jonthomasson/sx1238-500mw-rf-transceiver/rev1.a/img/3d-front.png

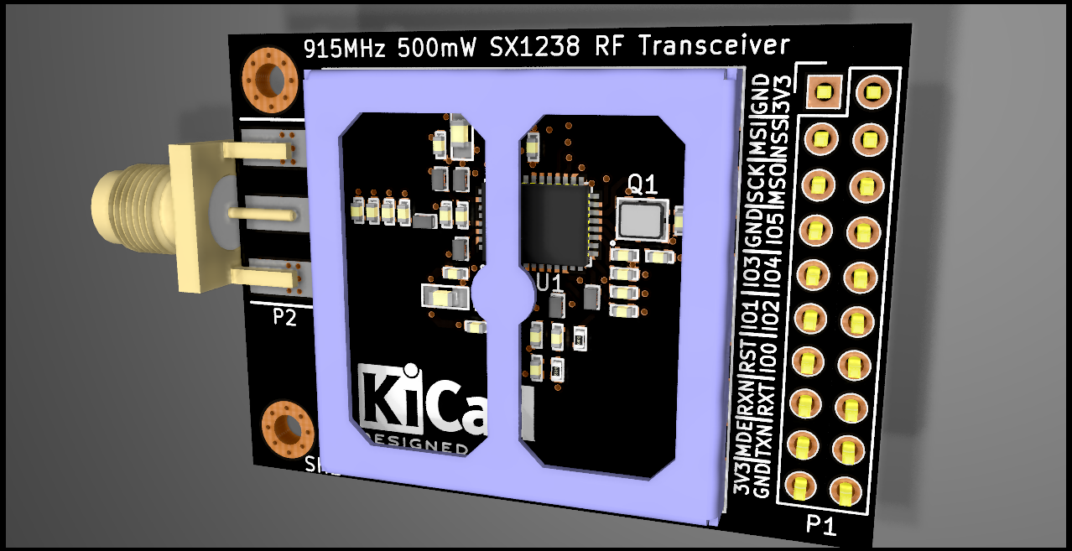
rev1.a/img/3d-front.png
