jonthomasson/sx1238-500mw-rf-transceiver/rev1.a/docs/microstrip_calc.PNG

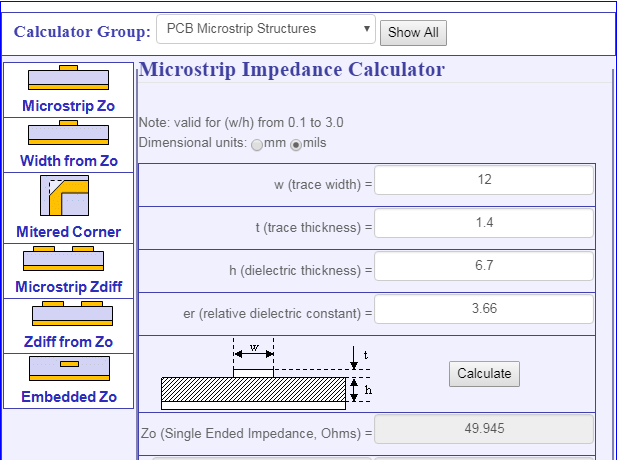
rev1.a/docs/microstrip_calc.PNG
