jonthomasson/sx1238-500mw-rf-transceiver/rev1.a/docs/oshpark_4layer_stackup.PNG

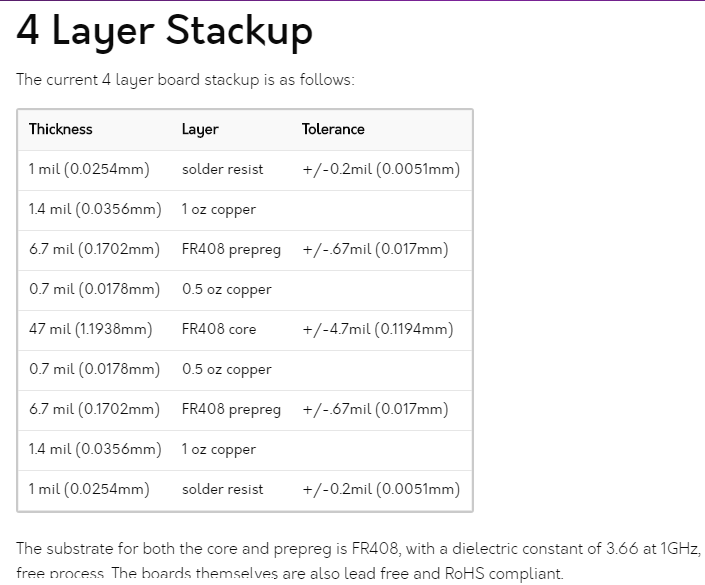
rev1.a/docs/oshpark_4layer_stackup.PNG
