jonthomasson/sx1238-500mw-rf-transceiver/rev1.a/img/3d-front-unpopulated.png

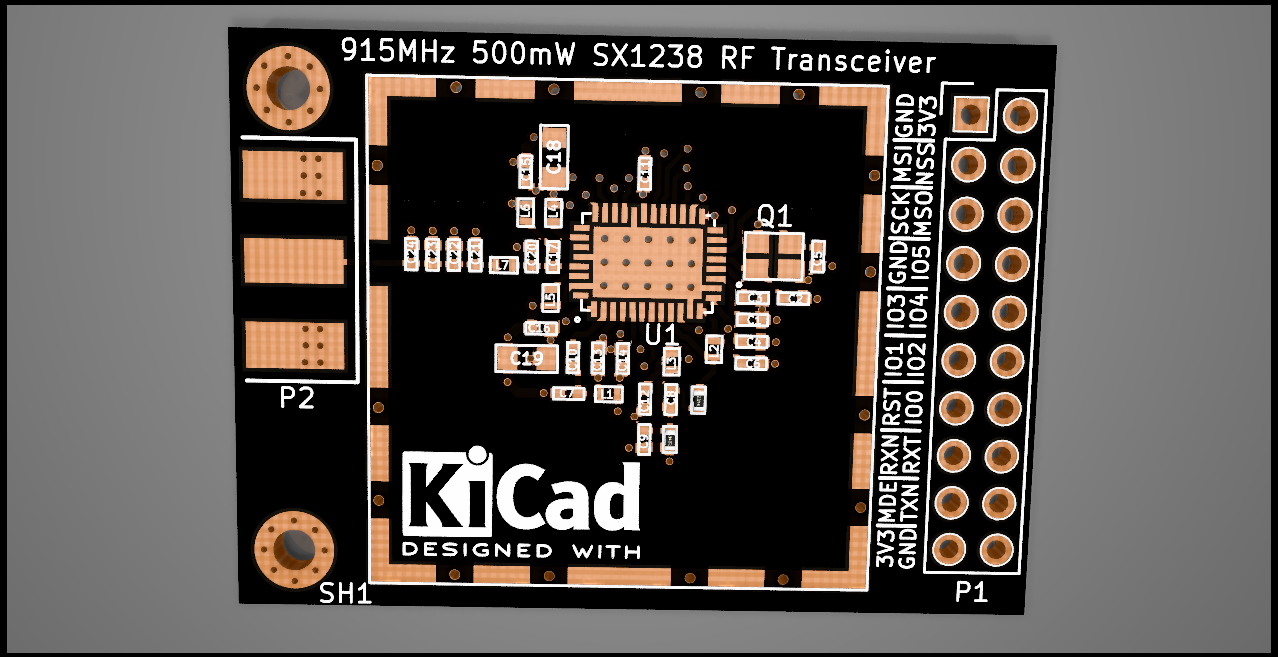
rev1.a/img/3d-front-unpopulated.png
