jonthomasson/sx1238-500mw-rf-transceiver/rev1.a/img/board.PNG

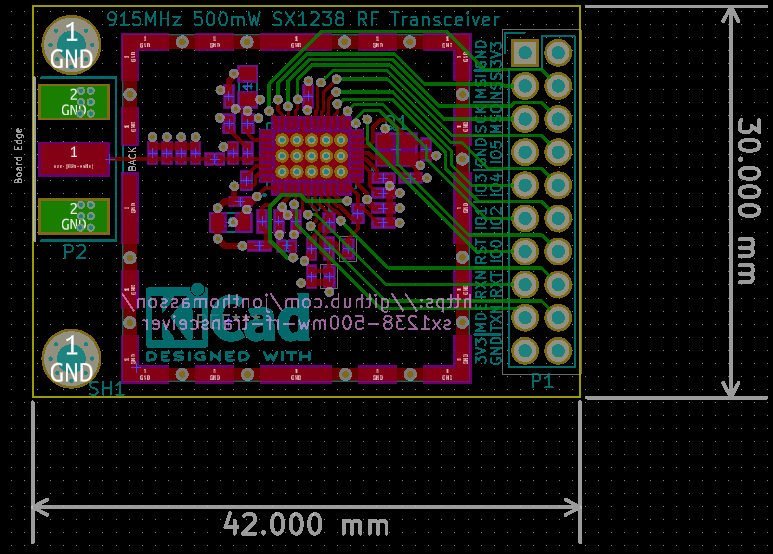
rev1.a/img/board.PNG
