jonthomasson/sx1238-500mw-rf-transceiver/rev1.a/3dmodels/wurth-shield-36103255.stp

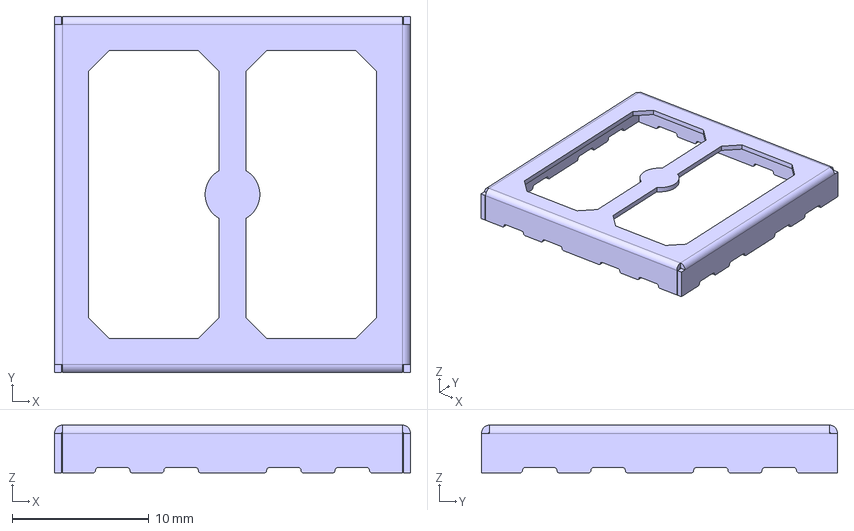
[picture p7: CAD file, 2018-03-14]
rev1.a/3dmodels/wurth-shield-36103255.stp
26.0 x 26.0 x 3.50 mm
