jonthomasson/sx1238-500mw-rf-transceiver/rev1.a/3dmodels/sma-142-0701-801.step

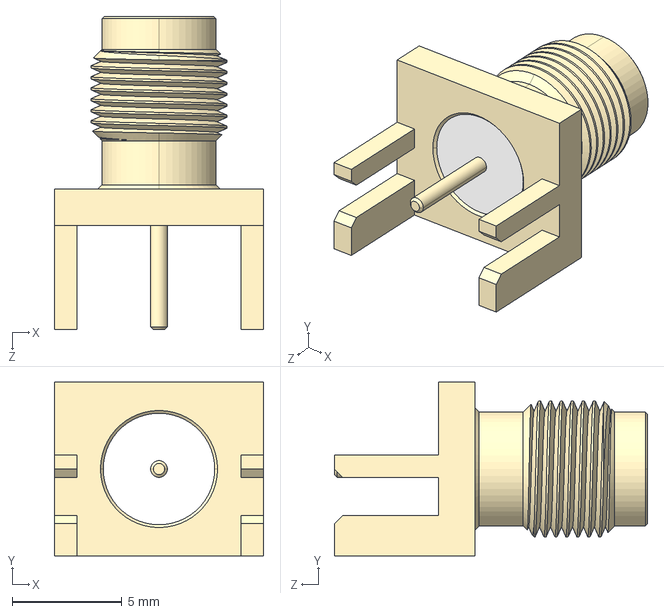
[picture p8: CAD file, 2018-03-14]
rev1.a/3dmodels/sma-142-0701-801.step
9.52 x 7.92 x 14.3 mm
