jonthomasson/sx1238-500mw-rf-transceiver/(list of files, cad)

Other CAD files:
rev1.a/3dmodels/36103255.stp
rev1.a/3dmodels/36103255 (rev1).igs
