jonthomasson/sx1238-500mw-rf-transceiver/rev1.a/docs/sx1238RfModule-schematic.pdf

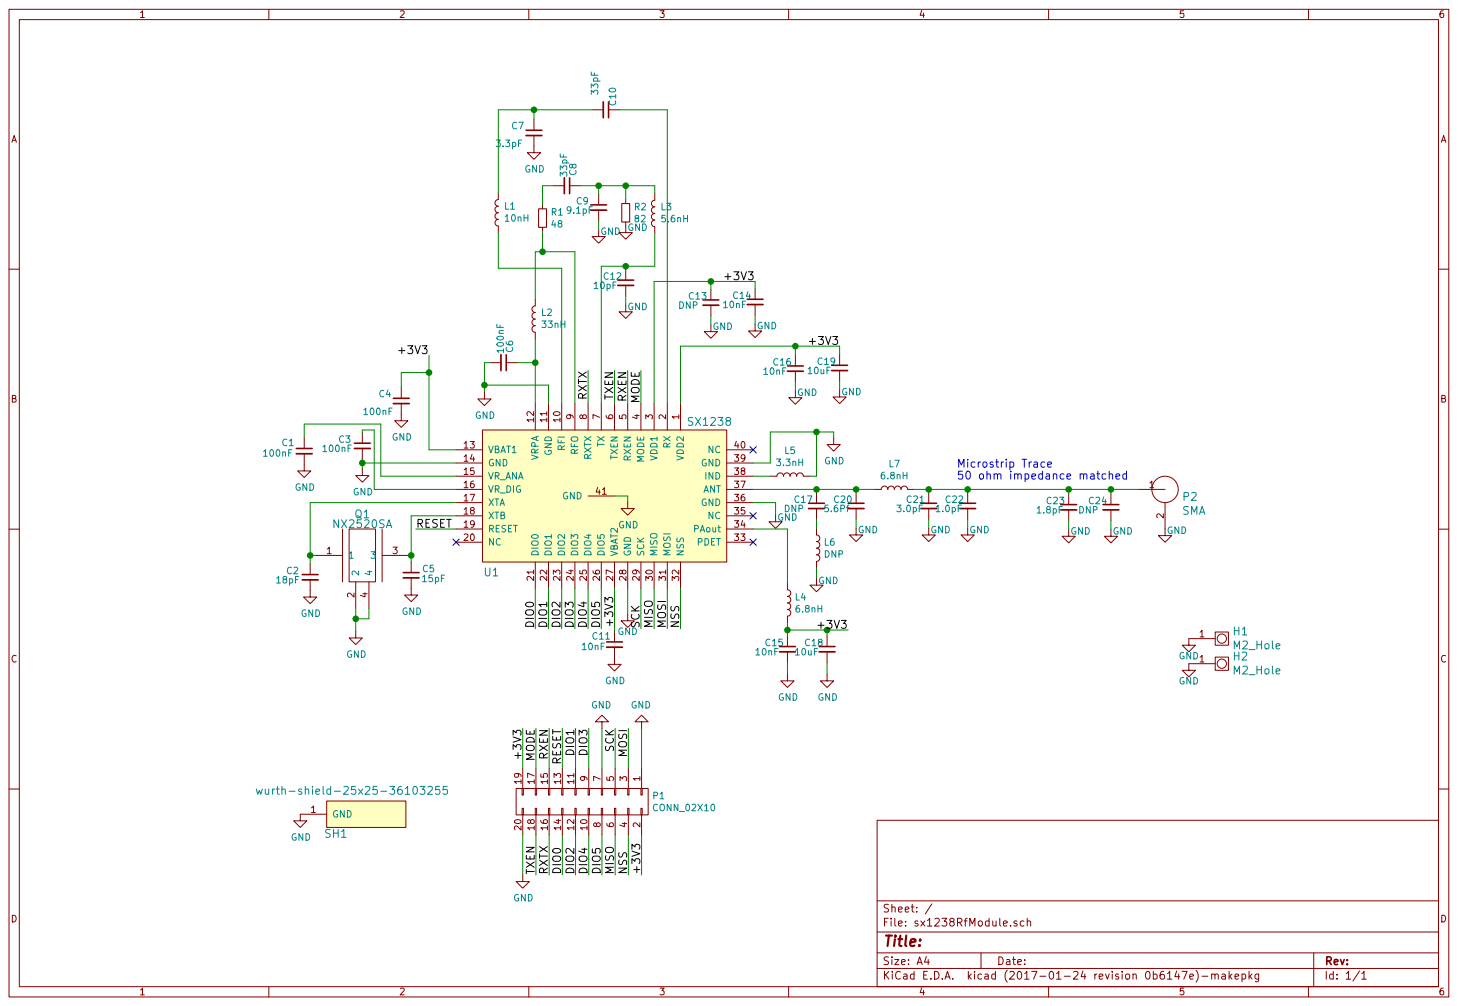
[picture p9: page 1]

9 RFI 10 NC 20 MISO 30 NC 40 GND 11 DIO0 21 MOSI 31 GND 41 VRPA 12 DIO1 22 NSS 32 VBAT1 13 DIO2 23 PDET 33 GND 14 DIO3 24 PAout 34 VR_ANA 15 DIO4 25 NC 35 VR_DIG 16 DIO5 26 GND 36 XTA 17 VBAT2 27 ANT 37 XTB 18 GND 28

Id: 1/1 Title: File: sx1238RfModule.sch Sheet: / VDD2

50 ohm impedance matched GND
