jonthomasson/sx1238-500mw-rf-transceiver/rev1.a/docs/sx1238RfModule-B.Cu.pdf

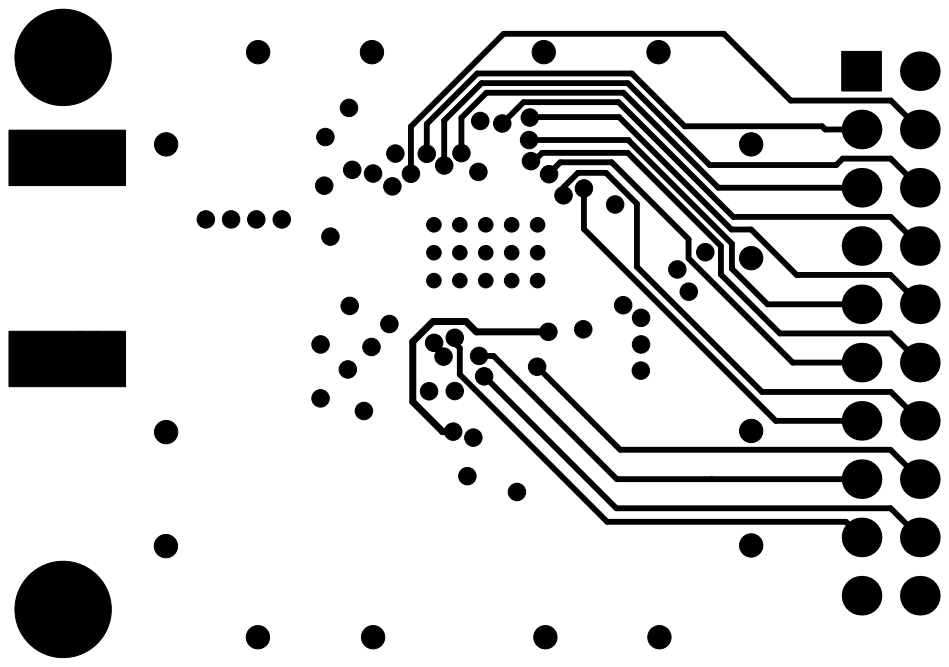
[picture p10: page 1]
