jonthomasson/sx1238-500mw-rf-transceiver/rev1.a/docs/sx1238RfModule-Dwgs.User.pdf

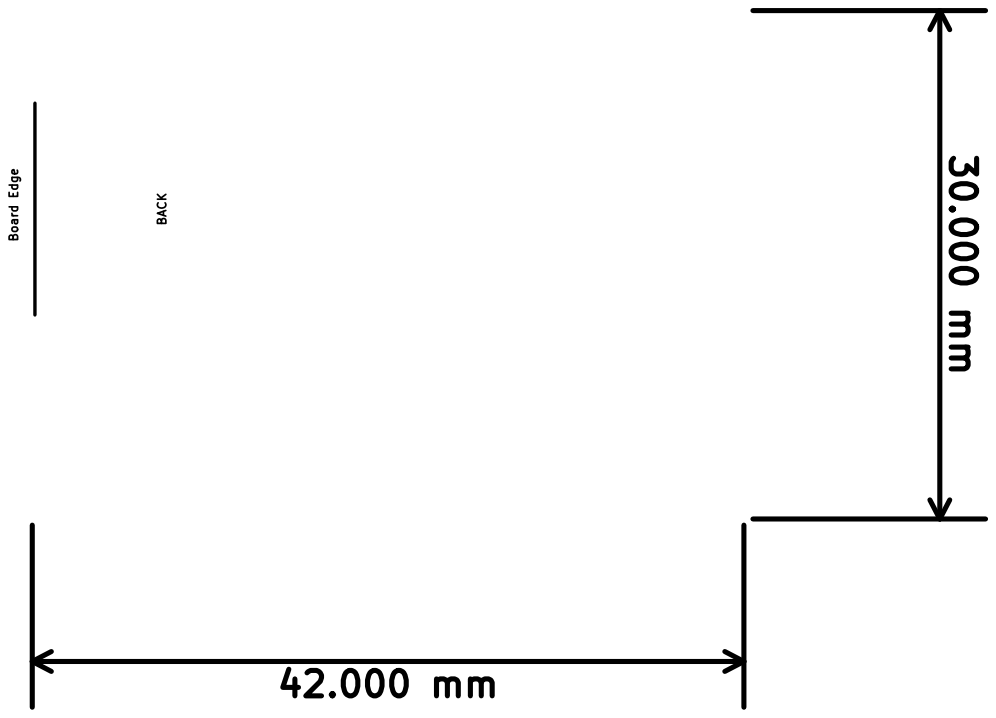
[picture p11: page 1]
