jonthomasson/sx1238-500mw-rf-transceiver/rev1.a/docs/sx1238RfModule-F.Cu.pdf

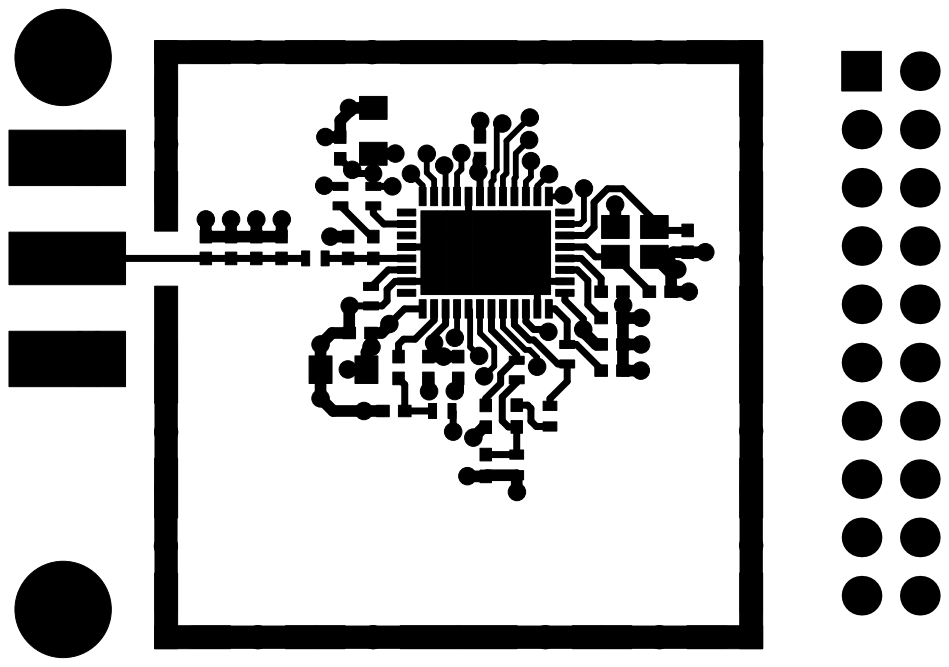
[picture p12: page 1]
