jonthomasson/sx1238-500mw-rf-transceiver/rev1.a/docs/sx1238RfModule-F.SilkS.pdf

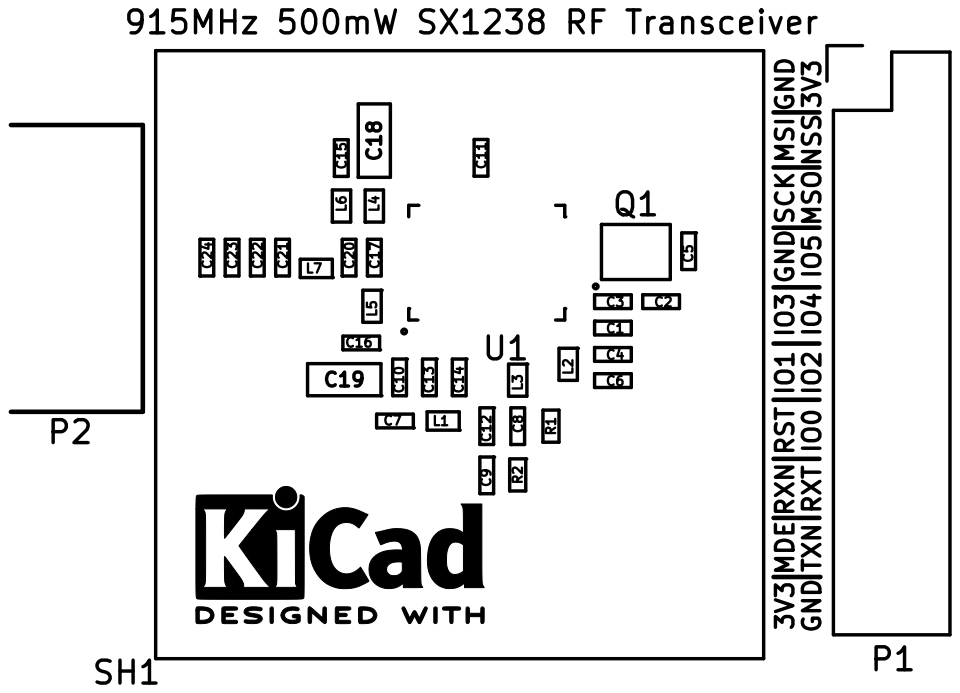
[picture p13: page 1]
