jonthomasson/sx1238-500mw-rf-transceiver/rev1.a/docs/sx1238RfModule-Layer2.pdf

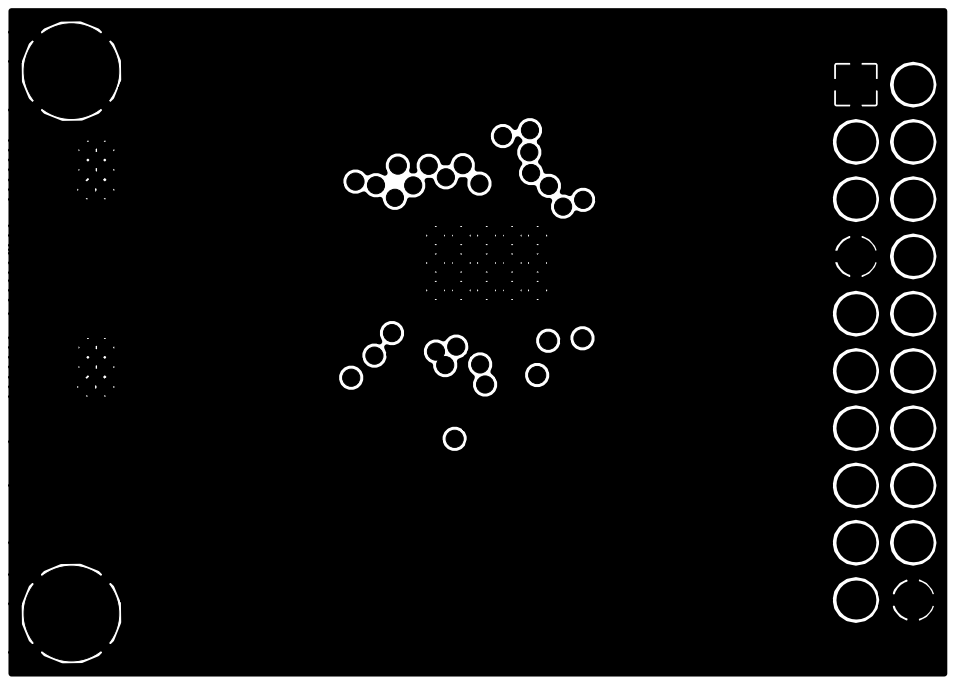
[picture p14: page 1]
