jonthomasson/sx1238-500mw-rf-transceiver/rev1.a/docs/sx1238RfModule-Layer3.pdf

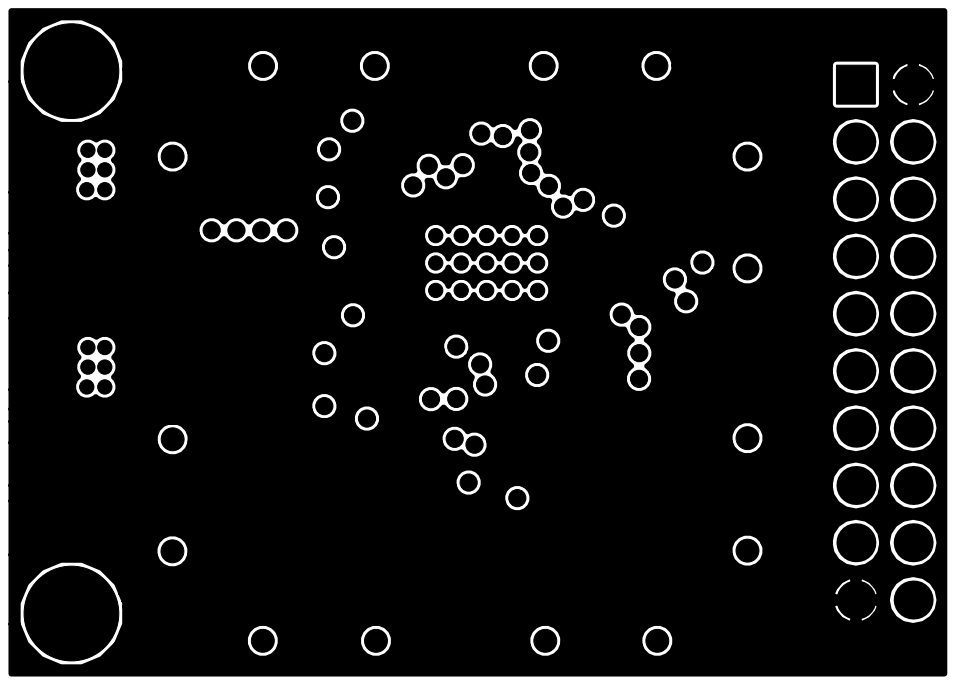
[picture p15: page 1]
