jonthomasson/sx1238-500mw-rf-transceiver/rev1.a/sx1238RfModule.kicad_pcb

## KiCad design rev1.a/sx1238RfModule.kicad_pcb (2018-03-14)

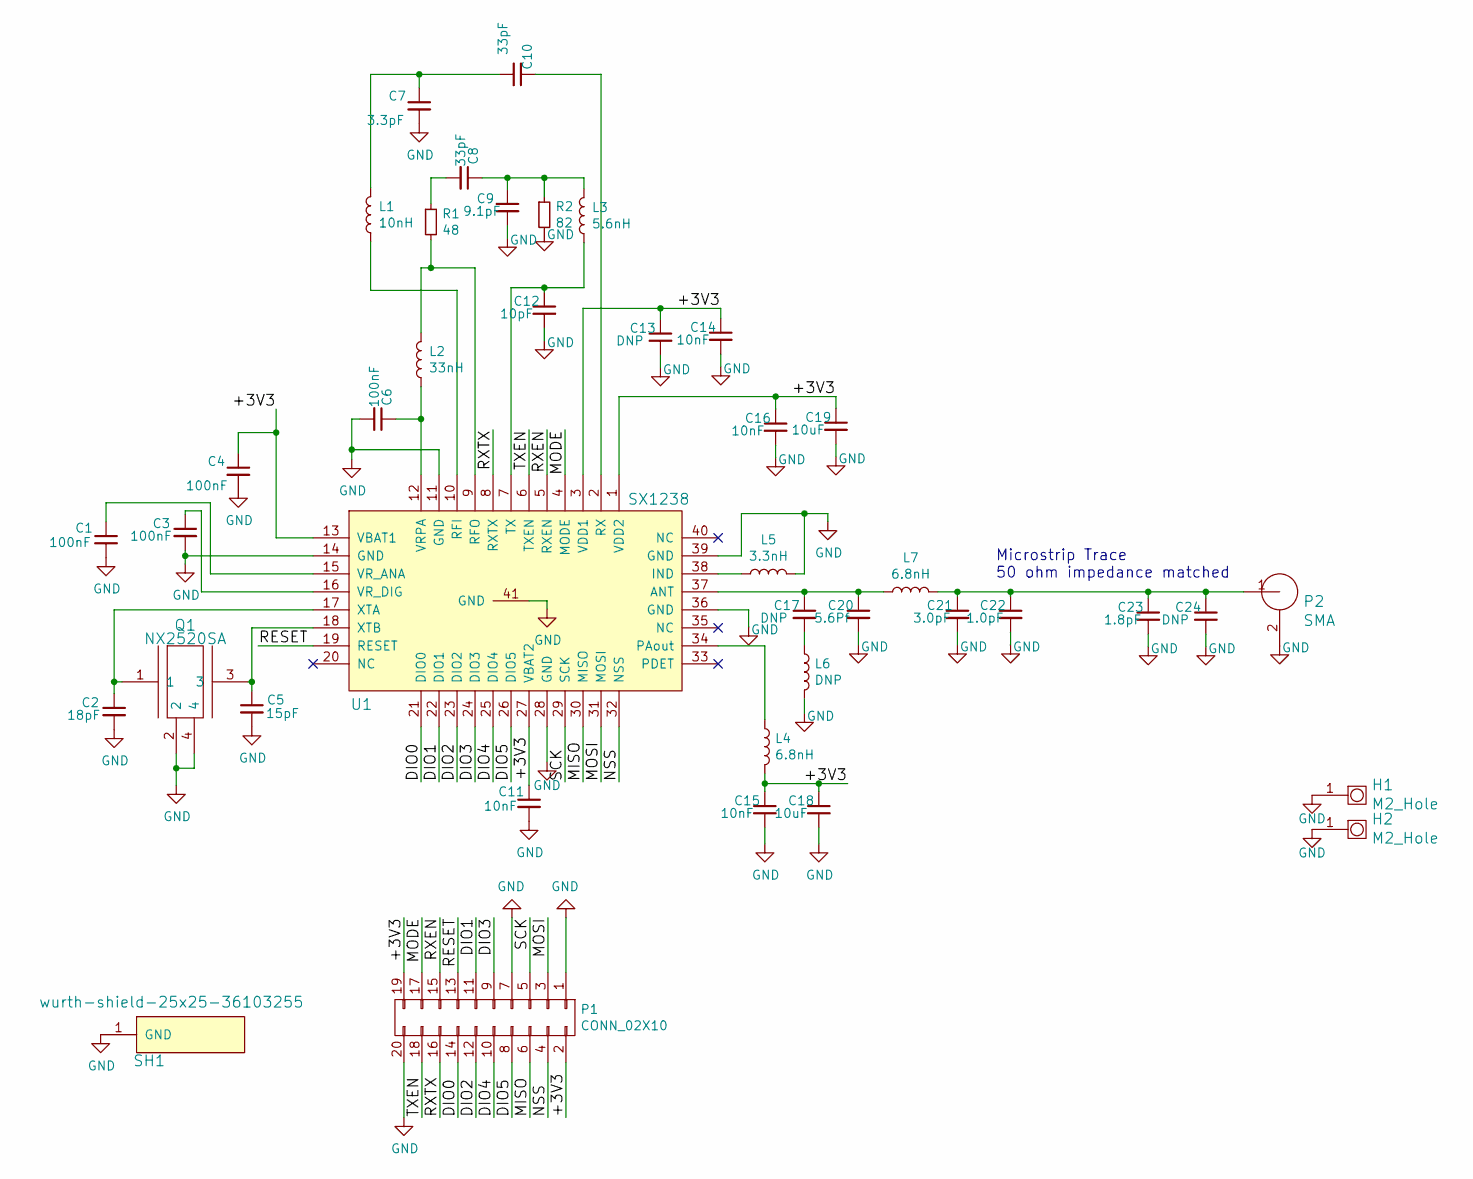
[picture p16: schematic sx1238RfModule.sch]

Parts:
C1, C3, C4, C6: 100nF; murata-cap-0402
C2: 18pF; murata-cap-0402
C5: 15pF; murata-cap-0402
C7: 3.3pF; murata-cap-0402
C8, C10: 33pF; murata-cap-0402
C9: 9.1pF; murata-cap-0402
C11, C14, C15, C16: 10nF; murata-cap-0402
C12: 10pF; murata-cap-0402
C13, C17, C24: DNP; murata-cap-0402
C18, C19: 10uF; murata-cap-0603
C20: 5.6Pf; murata-cap-0402
C21: 3.0pF; murata-cap-0402
C22: 1.0pF; murata-cap-0402
C23: 1.8pF; murata-cap-0402
H1, H2: M2_Hole; M2_2.2mm_mounting_hole
L1: 10nH; murata-inductor-0402
L2: 33nH; murata-inductor-0402
L3: 5.6nH; murata-inductor-0402
L4, L7: 6.8nH; murata-inductor-0402
L5: 3.3nH; murata-inductor-0402
L6: DNP; murata-inductor-0402
P1: CONN_02X10; Pin_Header_Straight_2x10
P2: SMA; 0732511150
Q1: NX2520SA; ndk-NX2520SA-32.000000MHZ
R1: 48; R_0402
R2: 82; R_0402
SH1: wurth-shield-25x25-36103255
U1: SX1238; semtech-sx1238

Connections:
/+3V3: C4.1, C11.1, C13.1, C14.1, C15.1, C16.1, C18.1, C19.1, L4.2, P1.2, P1.19, U1.1 (VDD2), U1.3 (VDD1), U1.13 (VBAT1), U1.27 (VBAT2)
/DIO0: P1.14, U1.21 (DIO0)
/DIO1: P1.11, U1.22 (DIO1)
/DIO2: P1.12, U1.23 (DIO2)
/DIO3: P1.9, U1.24 (DIO3)
/DIO4: P1.10, U1.25 (DIO4)
/DIO5: P1.8, U1.26 (DIO5)
/MISO: P1.6, U1.30 (MISO)
/MODE: P1.17, U1.4 (MODE)
/MOSI: P1.3, U1.31 (MOSI)
/NSS: P1.4, U1.32 (NSS)
/RESET: P1.13, U1.19 (RESET)
/RXEN: P1.15, U1.5 (RXEN)
/RXTX: P1.16, U1.8 (RXTX)
/SCK: P1.5, U1.29 (SCK)
/TXEN: P1.18, U1.6 (TXEN)
GND: C1.2, C2.2, C3.2, C4.2, C5.2, C6.2, C7.2, C9.2, C11.2, C12.2, C13.2, C14.2, C15.2, C16.2, C18.2, C19.2, C20.2, C21.2, C22.2, C23.2, C24.2, H1.1, H2.1, L5.2, L6.2, P1.1, P1.7, P1.20, P2.2, Q1.2, Q1.4, R2.2, SH1.1, U1.11 (GND), U1.14 (GND), U1.28 (GND), U1.36 (GND), U1.39 (GND), U1.41 (GND)
unnamed: C1.1, U1.15 (VR_ANA)
unnamed: C2.1, Q1.1, U1.17 (XTA)
unnamed: C3.1, U1.16 (VR_DIG)
unnamed: C5.1, Q1.3, U1.18 (XTB)
unnamed: C6.1, L2.1, U1.12 (VRPA)
unnamed: C8.1, C9.1, L3.2, R2.1
unnamed: C8.2, R1.1
unnamed: C10.1, U1.2 (RX)
unnamed: C7.1, C10.2, L1.2
unnamed: C12.1, L3.1, U1.7 (TX)
unnamed: C17.1, C20.1, L7.1, U1.37 (ANT)
unnamed: C17.2, L6.1
unnamed: C21.1, C22.1, C23.1, C24.1, L7.2, P2.1
unnamed: L1.1, U1.10 (RFI)
unnamed: L2.2, R1.2, U1.9 (RFO)
unnamed: L4.1, U1.34 (PAout)
unnamed: L5.1, U1.38 (IND)

Notes on the sheet:
Microstrip Trace 50 ohm impedance matched

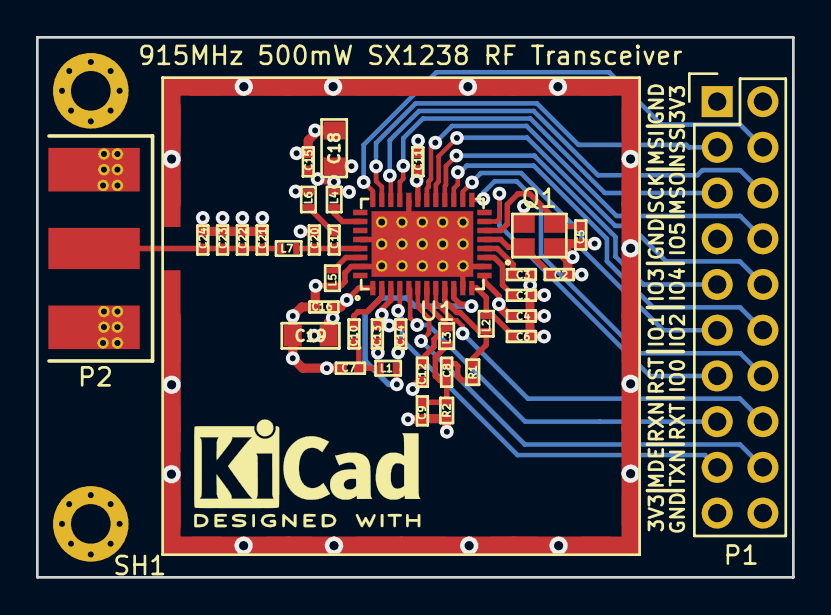
[picture p17: board sx1238RfModule.kicad_pcb from above]

Board: 4 copper layers, 42.0 x 30.0 mm, 40 parts (0 on the bottom side), 34 nets.
